MarcelKleiner/ViseClampingDevice/Hardware/Cobot/Cobot/Fertigungsdaten/Cobot-Edge_Cuts.pdf

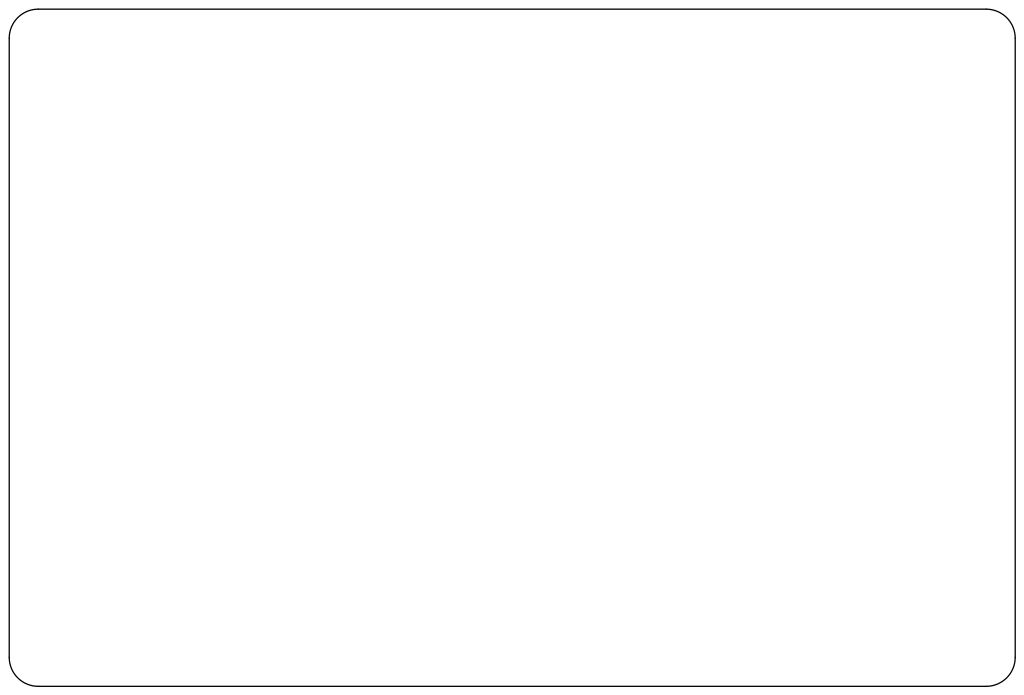
[picture p5: page 1]
