MarcelKleiner/ViseClampingDevice/Hardware/Cobot/Cobot/Fertigungsdaten/Cobot-F_Fab.pdf

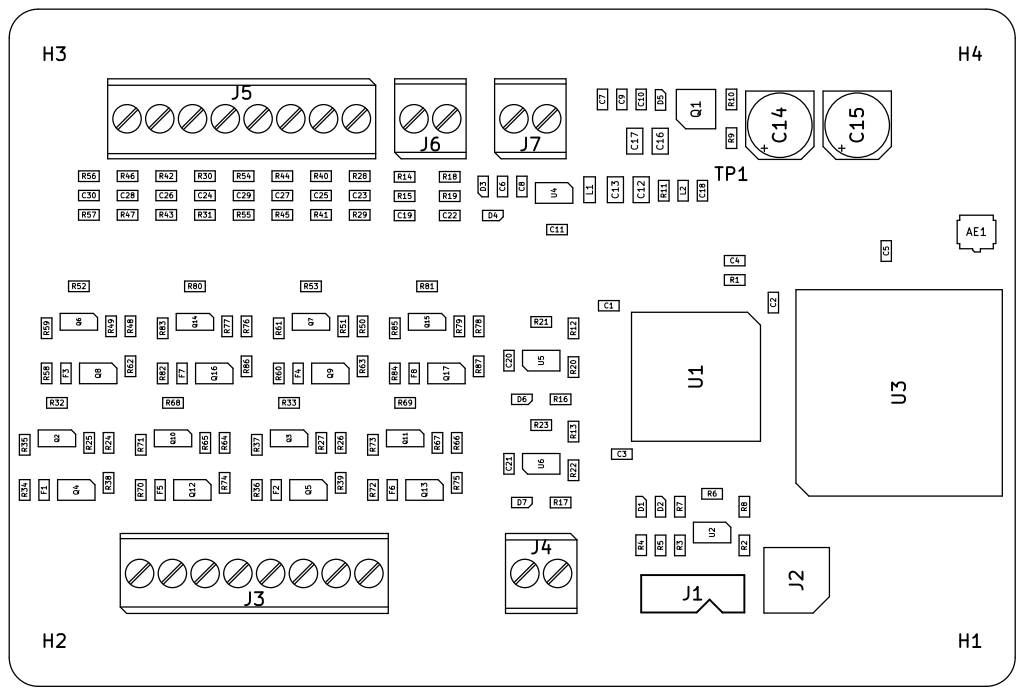
[picture p6: page 1]
