MarcelKleiner/ViseClampingDevice/Hardware/Spanner/Spanner/Fertigungsdaten/Spanner-F_Fab.pdf

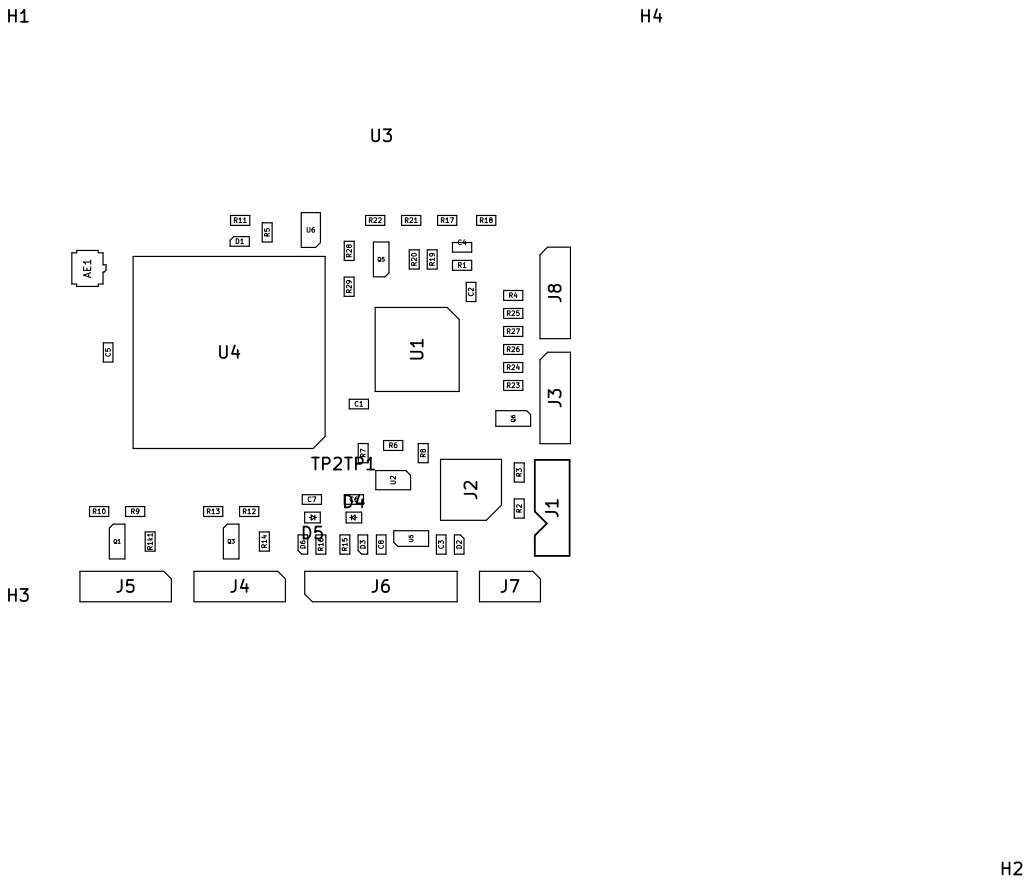
[picture p7: page 1]
