MarcelKleiner/ViseClampingDevice/Hardware/PowerSwitch/PowerSwitch/PowerSwitch.kicad_pcb

## KiCad design Hardware/PowerSwitch/PowerSwitch/PowerSwitch.kicad_pcb (2023-12-19)

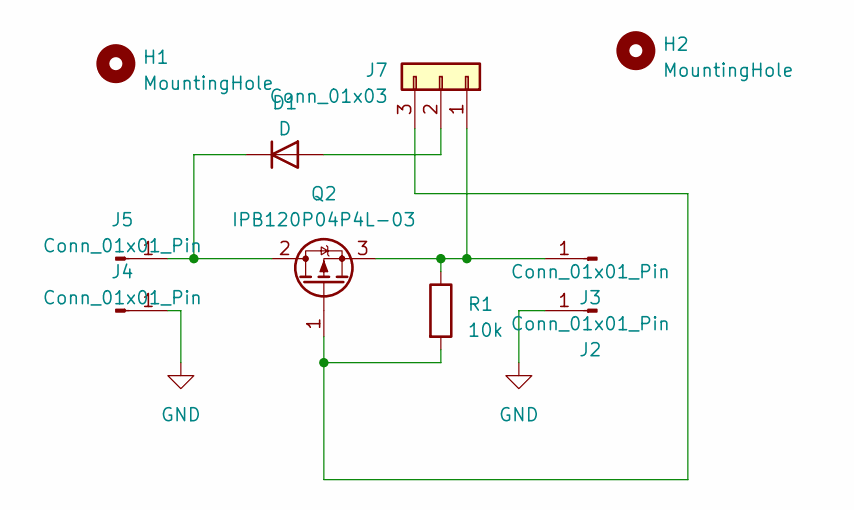
[picture p8: schematic PowerSwitch.kicad_sch]

Parts:
D1: D; D_1206_3216Metric
H1, H2: MountingHole; MountingHole_3.2mm_M3
J2, J3, J4, J5: Conn_01x01_Pin; MountingHole_3.2mm_M3_Pad_Via
J7: Conn_01x03; TerminalBlock_Phoenix_MPT-0,5-3-2.54_1x03_P2.54mm_Horizontal
Q2: IPB120P04P4L-03; TO-220-3_Vertical
R1: 10k; R_1206_3216Metric

Connections:
GND: J2.1, J4.1
unnamed: D1.2 (A), J7.2
unnamed: D1.1 (K), J5.1, Q2.2 (D)
unnamed: J3.1, J7.1, Q2.3 (S), R1.1
unnamed: J7.3, Q2.1 (G), R1.2

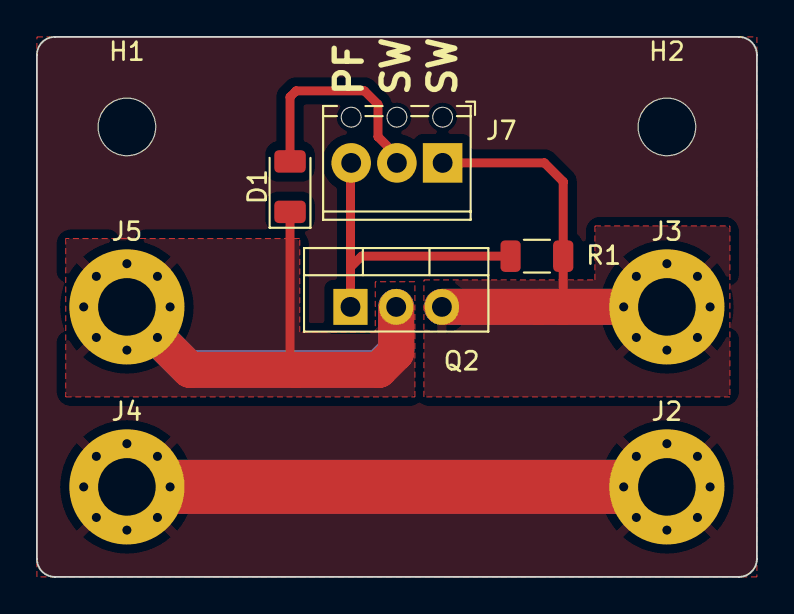
[picture p9: board PowerSwitch.kicad_pcb from above]

Board: 2 copper layers, 40.0 x 30.0 mm, 10 parts (0 on the bottom side), 5 nets.
