MarcelKleiner/ViseClampingDevice/Hardware/Cobot/Cobot/Cobot.kicad_pcb

## KiCad design Hardware/Cobot/Cobot/Cobot.kicad_pcb (2023-07-03)

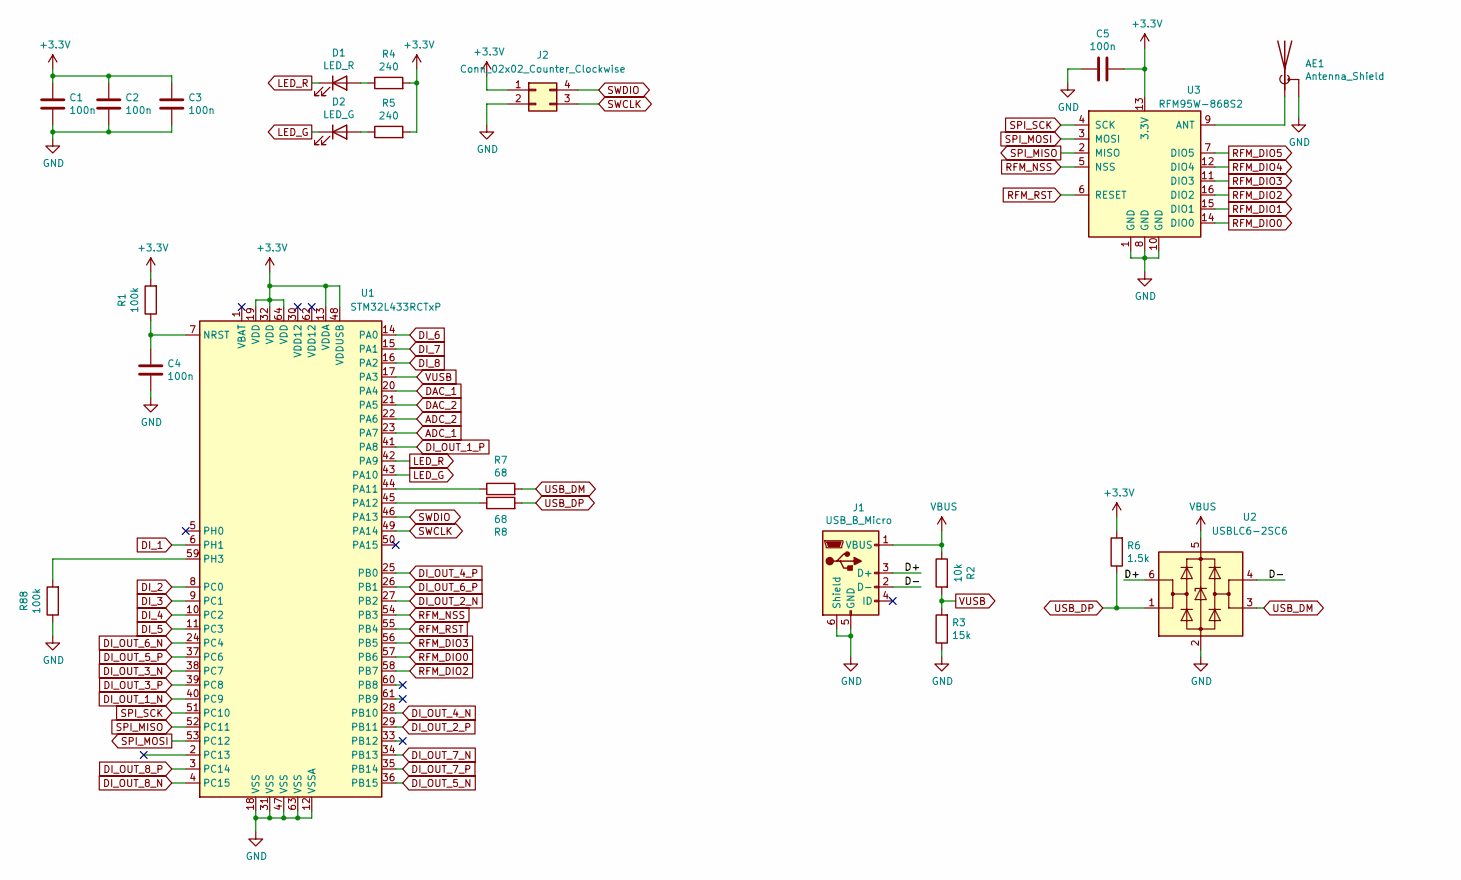
[picture p10: schematic Main.kicad_sch, part in row 1, column 1]

Parts:
AE1: Antenna_Shield; U.FL_Hirose_U.FL-R-SMT-1_Vertical; Mouser Nr. 712-CONUFL001-SMD-T
C1, C2, C3, C4, C5: 100n; C_0603_1608Metric; Mouser Nr. 187-CL10B104KB8NNWC
D1: LED_R; LED_0603_1608Metric; Mouser Nr. 696-SMLLXFP0603SICTR
D2: LED_G; LED_0603_1608Metric; Mouser Nr. 696-SMLLXFP0603SUGCT
J1: USB_B_Micro; USB_Micro-B_Wuerth_614105150721_Vertical; Mouser Nr. 710-614105150721
J2: Conn_02x02_Counter_Clockwise; PinHeader_2x02_P2.54mm_Vertical
R1, R88: 100k; R_0603_1608Metric; Mouser Nr. 71-CRCW0603100KFKEAC
R2: 10k; R_0603_1608Metric; Mouser Nr. 603-RT0603FRE0710KL
R3: 15k; R_0603_1608Metric; Mouser Nr. 667-ERJ-3EKF1502V
R4, R5: 240; R_0603_1608Metric; Mouser Nr. 603-RC0603FR-13240RL
R6: 1.5k; R_0603_1608Metric; Mouser Nr. 603-RT0603FRE101K5L
R7, R8: 68; R_0603_1608Metric; Mouser Nr. 603-RC0603JR-0768RL
U1: STM32L433RCTxP; LQFP-64_10x10mm_P0.5mm; Mouser Nr. 511-STM32L433RCT6P
U2: USBLC6-2SC6; SOT-23-6; Mouser Nr. 511-USBLC6-2SC6
U3: RFM95W-868S2; HOPERF_RFM9XW_SMD; Mouser Nr. 223-RFM95W-868S2

Connections:
+3.3V: C1.1, C2.1, C3.1, C5.2, J2.1, R1.2, R4.2, R5.2, R6.2, U1.13 (VDDA), U1.19 (VDD), U1.32 (VDD), U1.48 (VDDUSB), U1.64 (VDD), U3.13 (3.3V); also elsewhere on the board
/Main/D+: J1.3 (D+), U2.6 (I/O1)
/Main/D-: J1.2 (D-), U2.4 (I/O2)
ADC_1: U1.23 (PA7); also elsewhere on the board
ADC_2: U1.22 (PA6); also elsewhere on the board
DAC_1: U1.20 (PA4); also elsewhere on the board
DAC_2: U1.21 (PA5); also elsewhere on the board
DI_1: U1.6 (PH1); also elsewhere on the board
DI_2: U1.8 (PC0); also elsewhere on the board
DI_3: U1.9 (PC1); also elsewhere on the board
DI_4: U1.10 (PC2); also elsewhere on the board
DI_5: U1.11 (PC3); also elsewhere on the board
DI_6: U1.14 (PA0); also elsewhere on the board
DI_7: U1.15 (PA1); also elsewhere on the board
DI_8: U1.16 (PA2); also elsewhere on the board
DI_OUT_1_N: U1.40 (PC9); also elsewhere on the board
DI_OUT_1_P: U1.41 (PA8); also elsewhere on the board
DI_OUT_2_N: U1.27 (PB2); also elsewhere on the board
DI_OUT_2_P: U1.29 (PB11); also elsewhere on the board
DI_OUT_3_N: U1.38 (PC7); also elsewhere on the board
DI_OUT_3_P: U1.39 (PC8); also elsewhere on the board
DI_OUT_4_N: U1.28 (PB10); also elsewhere on the board
DI_OUT_4_P: U1.25 (PB0); also elsewhere on the board
DI_OUT_5_N: U1.36 (PB15); also elsewhere on the board
DI_OUT_5_P: U1.37 (PC6); also elsewhere on the board
DI_OUT_6_N: U1.24 (PC4); also elsewhere on the board
DI_OUT_6_P: U1.26 (PB1); also elsewhere on the board
DI_OUT_7_N: U1.34 (PB13); also elsewhere on the board
DI_OUT_7_P: U1.35 (PB14); also elsewhere on the board
DI_OUT_8_N: U1.4 (PC15); also elsewhere on the board
DI_OUT_8_P: U1.3 (PC14); also elsewhere on the board
LED_G: D2.1 (K), U1.43 (PA10)
LED_R: D1.1 (K), U1.42 (PA9)
unnamed: AE1.1 (A), U3.9 (ANT)
unnamed: D1.2 (A), R4.1
unnamed: D2.2 (A), R5.1
unnamed: C4.1, R1.1, U1.7 (NRST)
unnamed: R7.1, U1.44 (PA11)
unnamed: R8.1, U1.45 (PA12)
unnamed: R88.2, U1.59 (PH3)
RFM_DIO0: U1.57 (PB6), U3.14 (DIO0)
RFM_DIO1: U3.15 (DIO1)
RFM_DIO2: U1.58 (PB7), U3.16 (DIO2)
RFM_DIO3: U1.56 (PB5), U3.11 (DIO3)
RFM_DIO4: U3.12 (DIO4)
RFM_DIO5: U3.7 (DIO5)
RFM_NSS: U1.54 (PB3), U3.5 (NSS)
RFM_RST: U1.55 (PB4), U3.6 (RESET)
SPI_MISO: U1.52 (PC11), U3.2 (MISO)
SPI_MOSI: U1.53 (PC12), U3.3 (MOSI)
SPI_SCK: U1.51 (PC10), U3.4 (SCK)
SWCLK: J2.3, U1.49 (PA14)
SWDIO: J2.4, U1.46 (PA13)
USB_DM: R7.2, U2.3 (I/O2)
USB_DP: R6.1, R8.2, U2.1 (I/O1)
VBUS: J1.1 (VBUS), R2.1, U2.5 (VBUS); also elsewhere on the board
VUSB: R2.2, R3.2, U1.17 (PA3)

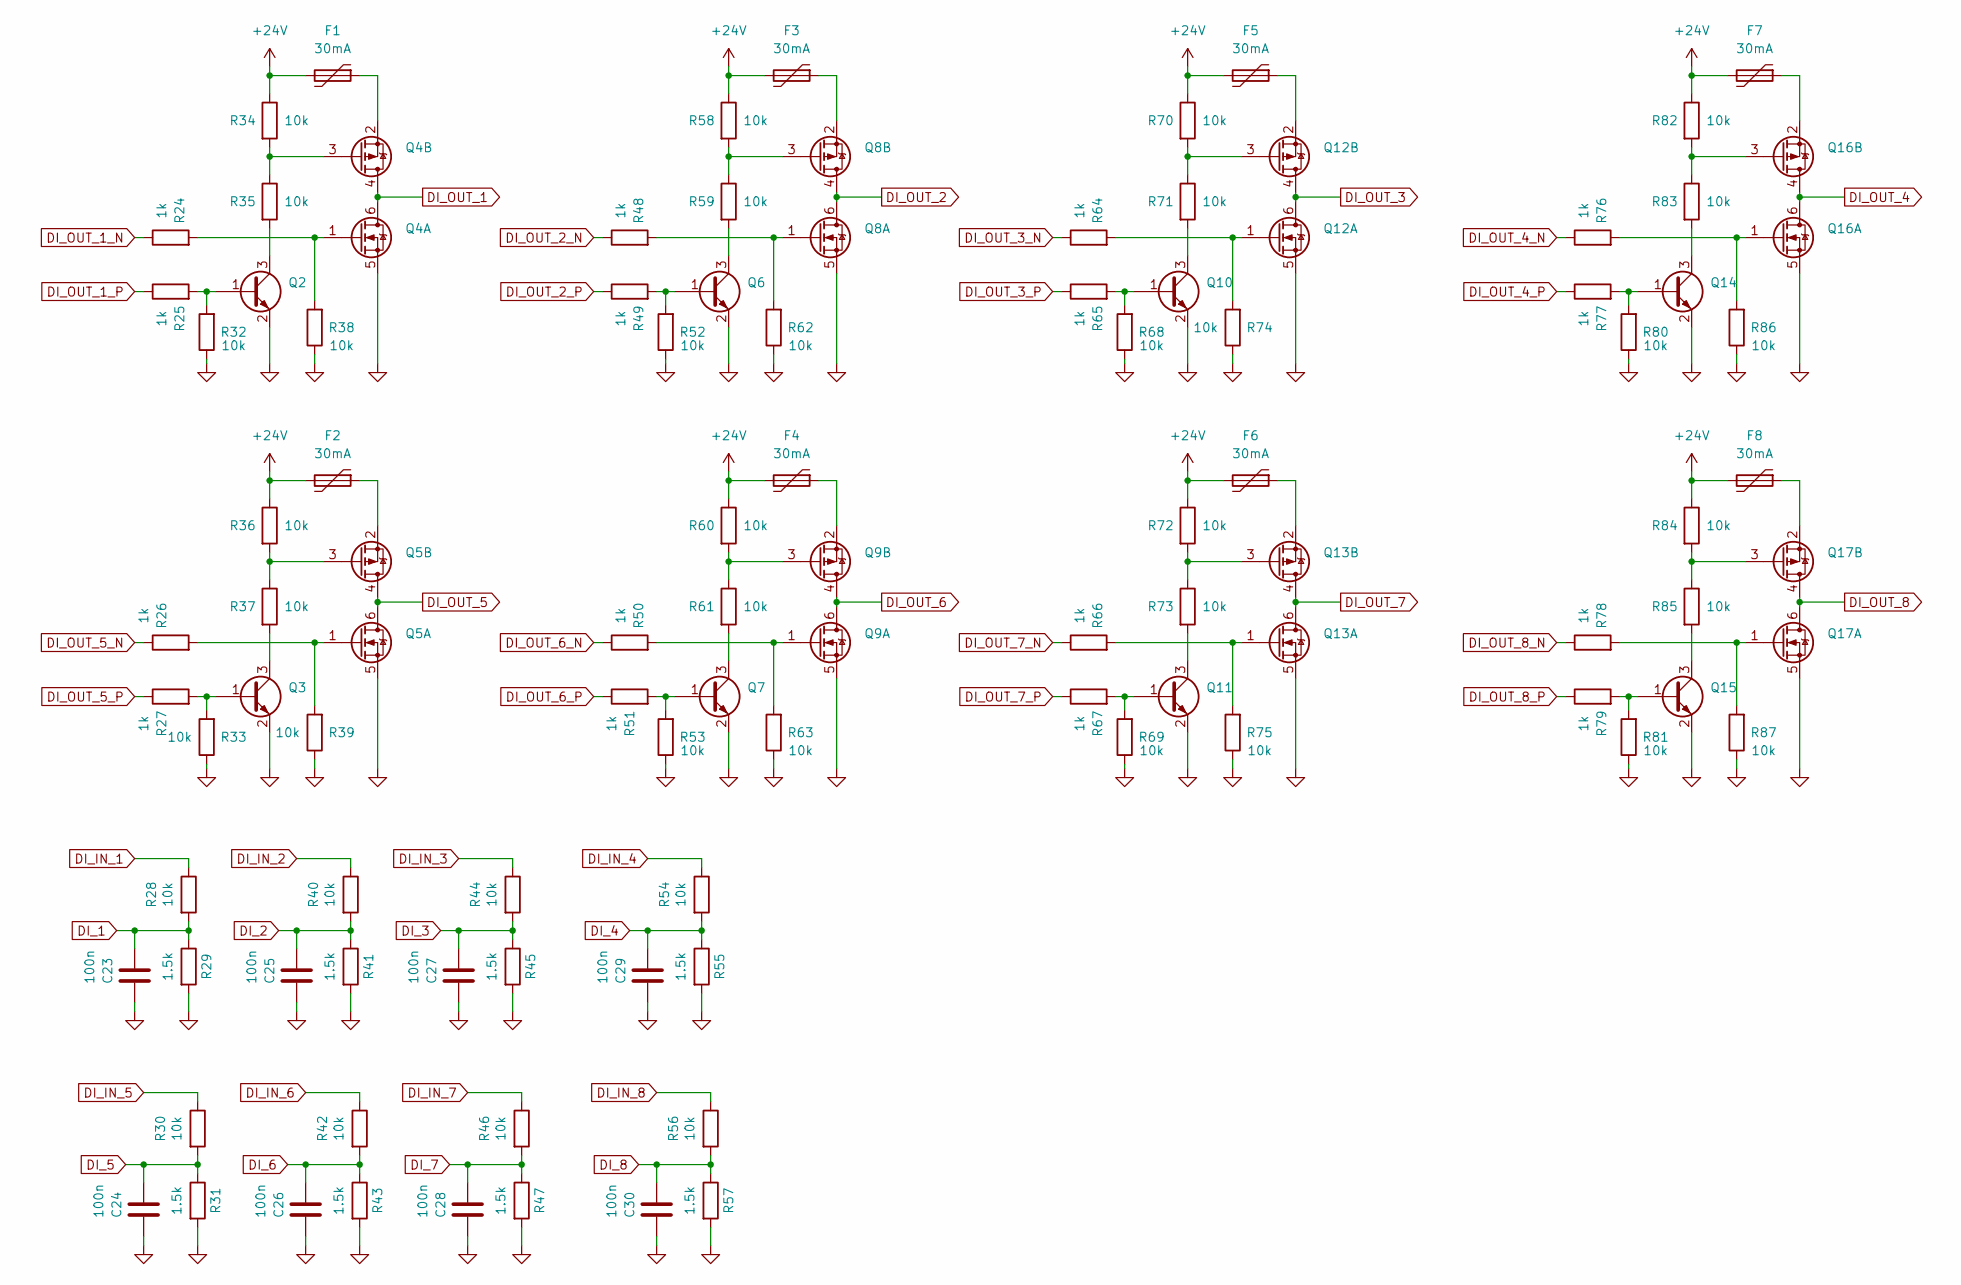
[picture p11: schematic IO_Digital.kicad_sch]

Parts:
C23, C24, C25, C26, C27, C28, C29, C30: 100n; C_0603_1608Metric; Mouser Nr. 187-CL10B104KB8NNWC
F1, F2, F3, F4, F5, F6, F7, F8: 30mA; Fuse_0603_1608Metric; Mouser Nr. 530-0ZCM0003FF2G
Q2, Q3, Q6, Q7, Q10, Q11, Q14, Q15: SOT-23; Mouser Nr. 771-BC846A235
Q4, Q5, Q8, Q9, Q12, Q13, Q16, Q17: SOT-23-6; Mouser Nr. 621-DMC2700UDM-7
R24, R25, R26, R27, R48, R49, R50, R51, R64, R65, R66, R67, R76, R77, R78, R79: 1k; R_0603_1608Metric; Mouser Nr. 603-RT0603FRE071KL
R28, R30, R32, R33, R34, R35, R36, R37, R38, R39, R40, R42, R44, R46, R52, R53, R54, R56, R58, R59, R60, R61, R62, R63, R68, R69, R70, R71, R72, R73, R74, R75, R80, R81, R82, R83, R84, R85, R86, R87: 10k; R_0603_1608Metric; Mouser Nr. 603-RT0603FRE0710KL
R29, R31, R41, R43, R45, R47, R55, R57: 1.5k; R_0603_1608Metric; Mouser Nr. 603-RT0603FRE101K5L

Connections:
+24V: F1.2, F2.2, F3.2, F4.2, F5.2, F6.2, F7.2, F8.2, R34.1, R36.1, R58.1, R60.1, R70.1, R72.1, R82.1, R84.1; also elsewhere on the board
DI_1: C23.1, R28.2, R29.1; also elsewhere on the board
DI_2: C25.1, R40.2, R41.1; also elsewhere on the board
DI_3: C27.1, R44.2, R45.1; also elsewhere on the board
DI_4: C29.1, R54.2, R55.1; also elsewhere on the board
DI_5: C24.1, R30.2, R31.1; also elsewhere on the board
DI_6: C26.1, R42.2, R43.1; also elsewhere on the board
DI_7: C28.1, R46.2, R47.1; also elsewhere on the board
DI_8: C30.1, R56.2, R57.1; also elsewhere on the board
DI_IN_1: R28.1; also elsewhere on the board
DI_IN_2: R40.1; also elsewhere on the board
DI_IN_3: R44.1; also elsewhere on the board
DI_IN_4: R54.1; also elsewhere on the board
DI_IN_5: R30.1; also elsewhere on the board
DI_IN_6: R42.1; also elsewhere on the board
DI_IN_7: R46.1; also elsewhere on the board
DI_IN_8: R56.1; also elsewhere on the board
DI_OUT_1: Q4.4 (D), Q4.6 (D); also elsewhere on the board
DI_OUT_1_N: R24.1; also elsewhere on the board
DI_OUT_1_P: R25.1; also elsewhere on the board
DI_OUT_2: Q8.4 (D), Q8.6 (D); also elsewhere on the board
DI_OUT_2_N: R48.1; also elsewhere on the board
DI_OUT_2_P: R49.1; also elsewhere on the board
DI_OUT_3: Q12.4 (D), Q12.6 (D); also elsewhere on the board
DI_OUT_3_N: R64.1; also elsewhere on the board
DI_OUT_3_P: R65.1; also elsewhere on the board
DI_OUT_4: Q16.4 (D), Q16.6 (D); also elsewhere on the board
DI_OUT_4_N: R76.1; also elsewhere on the board
DI_OUT_4_P: R77.1; also elsewhere on the board
DI_OUT_5: Q5.4 (D), Q5.6 (D); also elsewhere on the board
DI_OUT_5_N: R26.1; also elsewhere on the board
DI_OUT_5_P: R27.1; also elsewhere on the board
DI_OUT_6: Q9.4 (D), Q9.6 (D); also elsewhere on the board
DI_OUT_6_N: R50.1; also elsewhere on the board
DI_OUT_6_P: R51.1; also elsewhere on the board
DI_OUT_7: Q13.4 (D), Q13.6 (D); also elsewhere on the board
DI_OUT_7_N: R66.1; also elsewhere on the board
DI_OUT_7_P: R67.1; also elsewhere on the board
DI_OUT_8: Q17.4 (D), Q17.6 (D); also elsewhere on the board
DI_OUT_8_N: R78.1; also elsewhere on the board
DI_OUT_8_P: R79.1; also elsewhere on the board
unnamed: Q2.1 (B), R25.2, R32.2
unnamed: Q2.3 (C), R35.2
unnamed: Q3.1 (B), R27.2, R33.2
unnamed: Q3.3 (C), R37.2
unnamed: Q4.1 (G), R24.2, R38.2
unnamed: Q4.3 (G), R34.2, R35.1
unnamed: F1.1, Q4.2 (S)
unnamed: Q5.1 (G), R26.2, R39.2
unnamed: Q5.3 (G), R36.2, R37.1
unnamed: F2.1, Q5.2 (S)
unnamed: Q6.1 (B), R49.2, R52.2
unnamed: Q6.3 (C), R59.2
unnamed: Q7.1 (B), R51.2, R53.2
unnamed: Q7.3 (C), R61.2
unnamed: Q8.1 (G), R48.2, R62.2
unnamed: Q8.3 (G), R58.2, R59.1
unnamed: F3.1, Q8.2 (S)
unnamed: Q9.1 (G), R50.2, R63.2
unnamed: Q9.3 (G), R60.2, R61.1
unnamed: F4.1, Q9.2 (S)
unnamed: Q10.1 (B), R65.2, R68.2
unnamed: Q10.3 (C), R71.2
unnamed: Q11.1 (B), R67.2, R69.2
unnamed: Q11.3 (C), R73.2
unnamed: Q12.1 (G), R64.2, R74.2
unnamed: Q12.3 (G), R70.2, R71.1
unnamed: F5.1, Q12.2 (S)
unnamed: Q13.1 (G), R66.2, R75.2
unnamed: Q13.3 (G), R72.2, R73.1
unnamed: F6.1, Q13.2 (S)
unnamed: Q14.1 (B), R77.2, R80.2
unnamed: Q14.3 (C), R83.2
unnamed: Q15.1 (B), R79.2, R81.2
unnamed: Q15.3 (C), R85.2
unnamed: Q16.1 (G), R76.2, R86.2
unnamed: Q16.3 (G), R82.2, R83.1
unnamed: F7.1, Q16.2 (S)
unnamed: Q17.1 (G), R78.2, R87.2
unnamed: Q17.3 (G), R84.2, R85.1
unnamed: F8.1, Q17.2 (S)

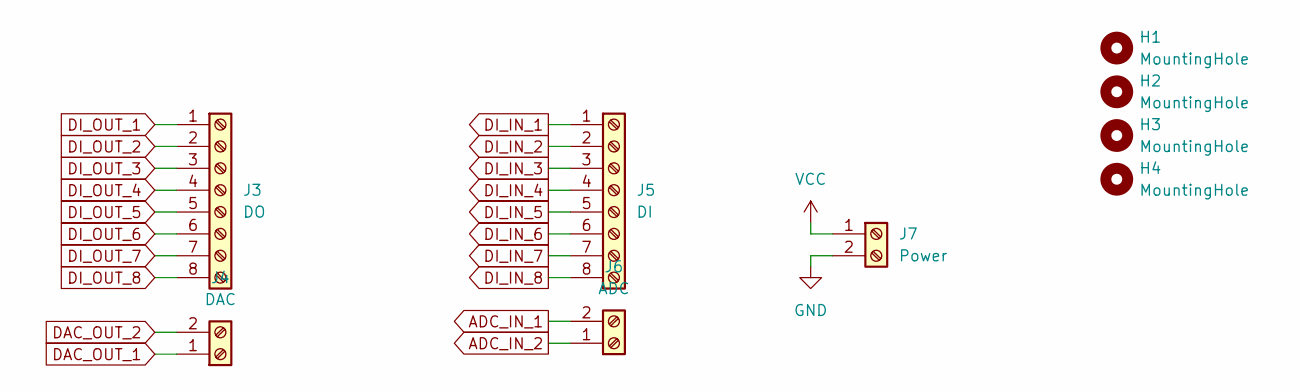
[picture p12: schematic Connection.kicad_sch]

Parts:
H1, H2, H3, H4: MountingHole; MountingHole_3.2mm_M3
J3: DO; TerminalBlock_Phoenix_MPT-0,5-8-2.54_1x08_P2.54mm_Horizontal
J4: DAC; TerminalBlock_Phoenix_MPT-0,5-2-2.54_1x02_P2.54mm_Horizontal
J5: DI; TerminalBlock_Phoenix_MPT-0,5-8-2.54_1x08_P2.54mm_Horizontal
J6: ADC; TerminalBlock_Phoenix_MPT-0,5-2-2.54_1x02_P2.54mm_Horizontal
J7: Power; TerminalBlock_Phoenix_MPT-0,5-2-2.54_1x02_P2.54mm_Horizontal

Connections:
ADC_IN_1: J6.2; also elsewhere on the board
ADC_IN_2: J6.1; also elsewhere on the board
DAC_OUT_1: J4.1; also elsewhere on the board
DAC_OUT_2: J4.2; also elsewhere on the board
DI_IN_1: J5.1; also elsewhere on the board
DI_IN_2: J5.2; also elsewhere on the board
DI_IN_3: J5.3; also elsewhere on the board
DI_IN_4: J5.4; also elsewhere on the board
DI_IN_5: J5.5; also elsewhere on the board
DI_IN_6: J5.6; also elsewhere on the board
DI_IN_7: J5.7; also elsewhere on the board
DI_IN_8: J5.8; also elsewhere on the board
DI_OUT_1: J3.1; also elsewhere on the board
DI_OUT_2: J3.2; also elsewhere on the board
DI_OUT_3: J3.3; also elsewhere on the board
DI_OUT_4: J3.4; also elsewhere on the board
DI_OUT_5: J3.5; also elsewhere on the board
DI_OUT_6: J3.6; also elsewhere on the board
DI_OUT_7: J3.7; also elsewhere on the board
DI_OUT_8: J3.8; also elsewhere on the board
VCC: J7.1; also elsewhere on the board

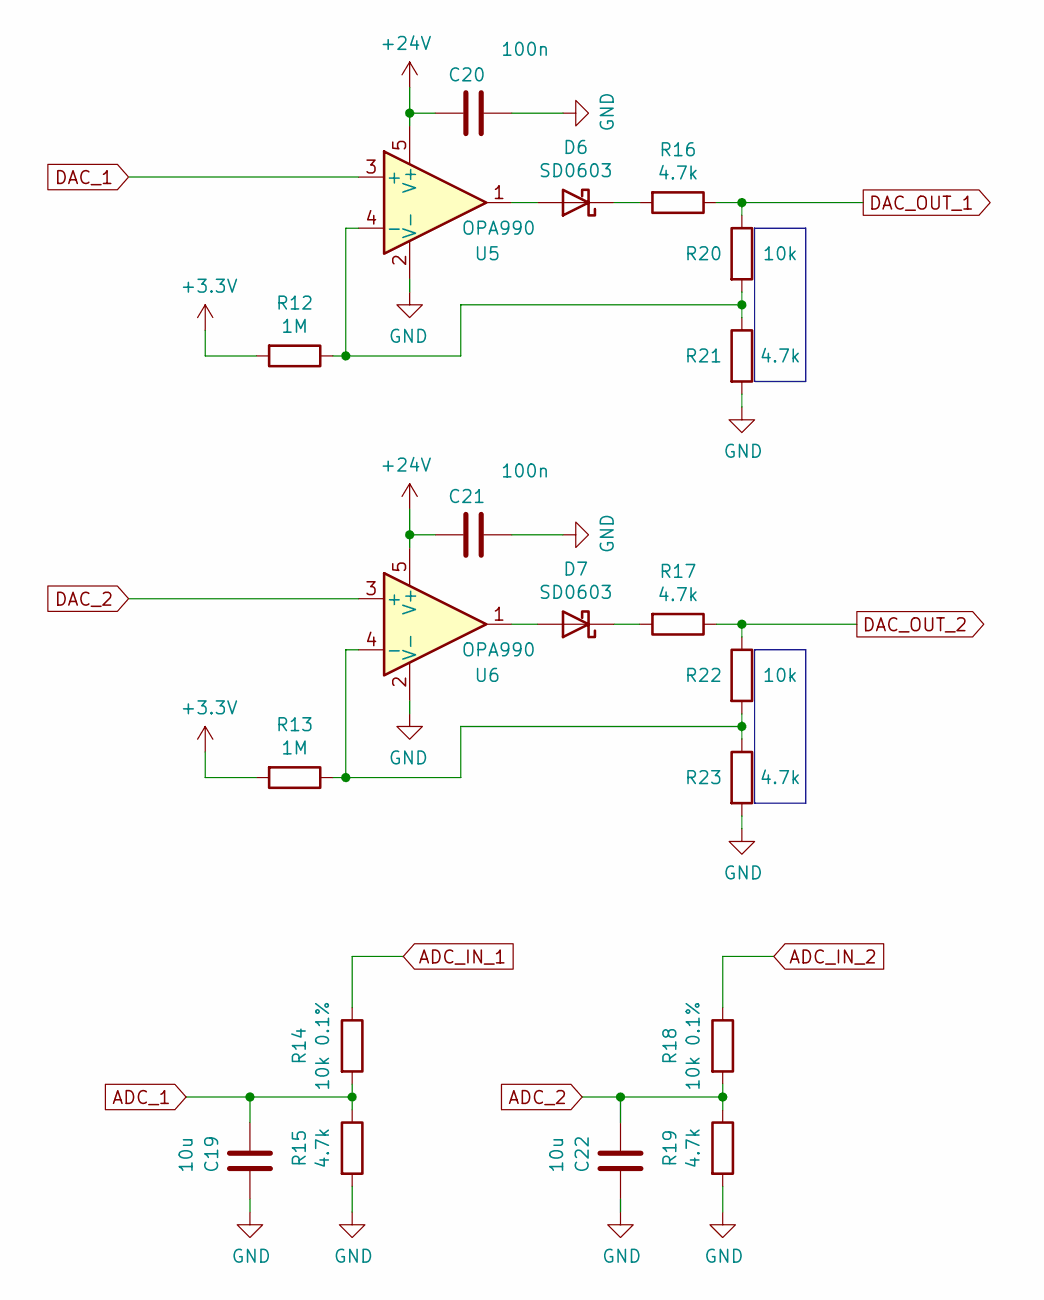
[picture p13: schematic IO_Analog.kicad_sch]

Parts:
C19, C22: 10u; C_0603_1608Metric; Mouser Nr. 187-CL10A106MA8NRNC
C20, C21: 100n; C_0603_1608Metric; Mouser Nr. 187-CL10B104KB8NNWC
D6, D7: SD0603; D_0603_1608Metric; Mouser Nr. 581-SD0603S040S0R2
R12, R13: 1M; R_0603_1608Metric; Mouser Nr. 667-ERJ-3GEYJ105V
R14, R18: 10k 0.1%; R_0603_1608Metric; Mouser Nr. 284-APC0603B10K0N
R15, R16, R17, R19, R21, R23: 4.7k; R_0603_1608Metric; Mouser Nr. 603-RT0603FRE074K7L
R20, R22: 10k; R_0603_1608Metric; Mouser Nr. 603-RT0603FRE0710KL
U5, U6: OPA990; SOT-23-5; Mouser Nr. 595-OPA990IDBVR

Connections:
+3.3V: R12.2, R13.2; also elsewhere on the board
+24V: C20.1, C21.1, U5.5 (V+), U6.5 (V+); also elsewhere on the board
ADC_1: C19.1, R14.2, R15.1; also elsewhere on the board
ADC_2: C22.1, R18.2, R19.1; also elsewhere on the board
ADC_IN_1: R14.1; also elsewhere on the board
ADC_IN_2: R18.1; also elsewhere on the board
DAC_1: U5.3 (+); also elsewhere on the board
DAC_2: U6.3 (+); also elsewhere on the board
DAC_OUT_1: R16.1, R20.1; also elsewhere on the board
DAC_OUT_2: R17.1, R22.1; also elsewhere on the board
unnamed: D6.2 (A), U5.1
unnamed: D6.1 (K), R16.2
unnamed: D7.2 (A), U6.1
unnamed: D7.1 (K), R17.2
unnamed: R12.1, R20.2, R21.1, U5.4 (-)
unnamed: R13.1, R22.2, R23.1, U6.4 (-)

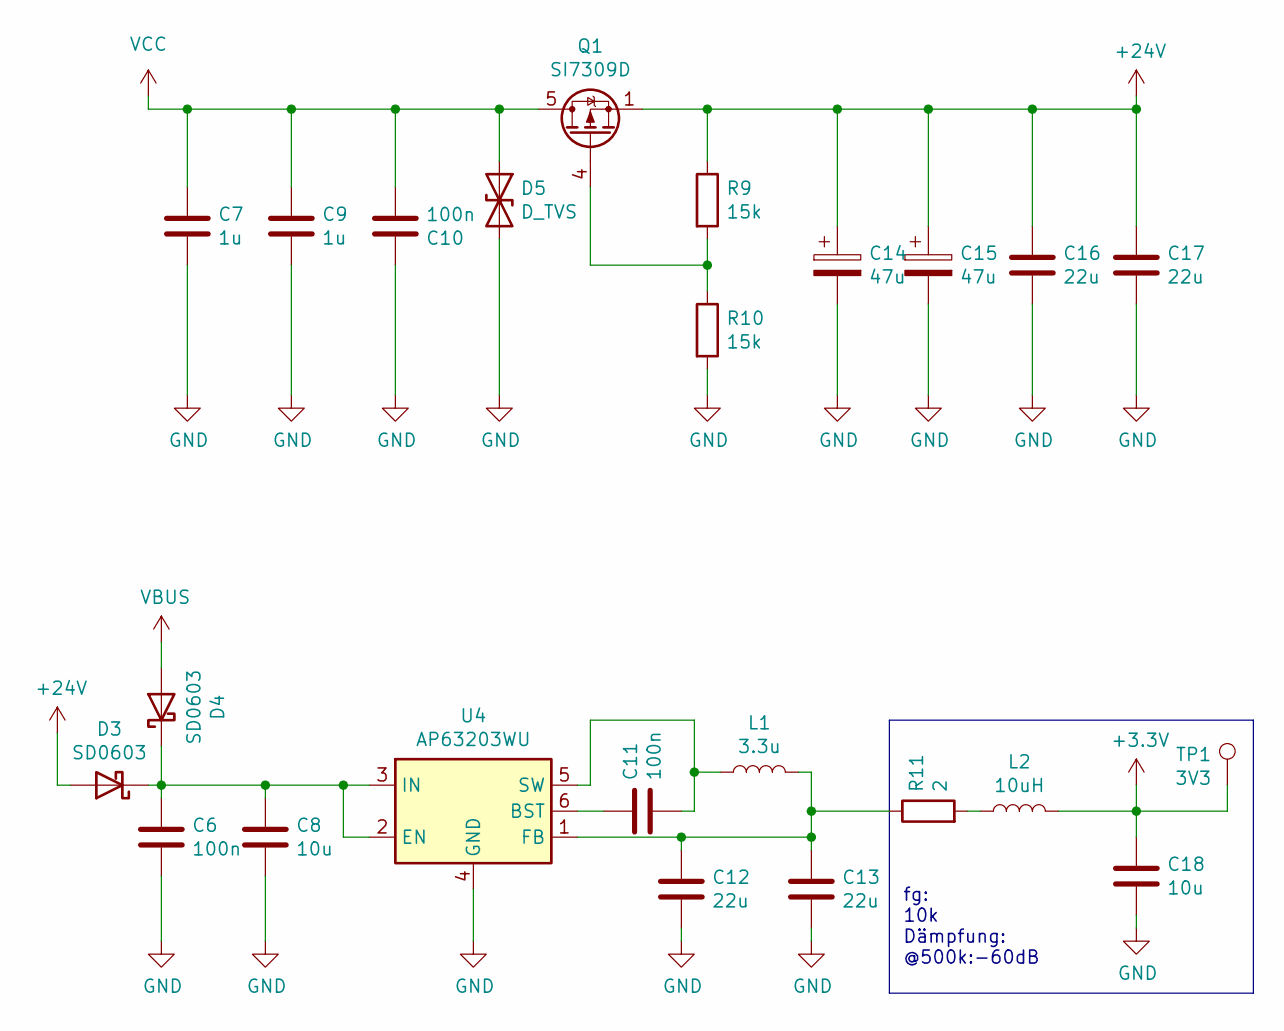
[picture p14: schematic Supply.kicad_sch]

Parts:
C6, C10, C11: 100n; C_0603_1608Metric; Mouser Nr. 187-CL10B104KB8NNWC
C7, C9: 1u; C_0603_1608Metric; Mouser Nr. 187-CL10A105KA8NFNC
C8, C18: 10u; C_0603_1608Metric; Mouser Nr. 187-CL10A106MA8NRNC
C12, C13, C16, C17: 22u; C_0805_2012Metric; Mouser Nr. 187-CL21A226MAYNNNE
C14, C15: 47u; CP_Elec_5x5.8; Mouser Nr. 667-EEE-FT1V470AR
D3, D4: SD0603; D_0603_1608Metric; Mouser Nr. 581-SD0603S040S0R2
D5: D_TVS; D_0603_1608Metric
L1: 3.3u; L_0805_2012Metric; Mouser Nr. 70-IMC0805ER3R3J01
L2: 10uH; L_0603_1608Metric; Mouser Nr. 81-LQM18DH100M70L
Q1: SI7309D; Vishay_PowerPAK_1212-8_Single; Mouser Nr. 781-SI7309DN-T1-E3
R9, R10: 15k; R_0603_1608Metric; Mouser Nr. 667-ERJ-3EKF1502V
R11: 2; R_0603_1608Metric; Mouser Nr. 652-CR0603-J/-2R0ELF
TP1: 3V3; TestPoint_Pad_D1.0mm
U4: AP63203WU; SOT-23-6; Mouser Nr. 621-AP63203WU-7

Connections:
+3.3V: C18.2, L2.2, TP1.1; also elsewhere on the board
+24V: C14.1, C15.1, C16.2, C17.2, D3.2 (A), Q1.1 (S), Q1.2 (S), Q1.3 (S), R9.1; also elsewhere on the board
unnamed: C6.1, C8.1, D3.1 (K), D4.1 (K), U4.2 (EN), U4.3 (IN)
unnamed: L2.1, R11.2
unnamed: Q1.4 (G), R9.2, R10.1
unnamed: C11.2, U4.6 (BST)
unnamed: C12.2, C13.2, L1.2, R11.1, U4.1 (FB)
unnamed: C11.1, L1.1, U4.5 (SW)
VBUS: D4.2 (A); also elsewhere on the board
VCC: C7.2, C9.2, C10.1, D5.1 (A1), Q1.5 (D); also elsewhere on the board

Notes on the sheet:
fg: 10k Dämpfung: @500k:-60dB

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
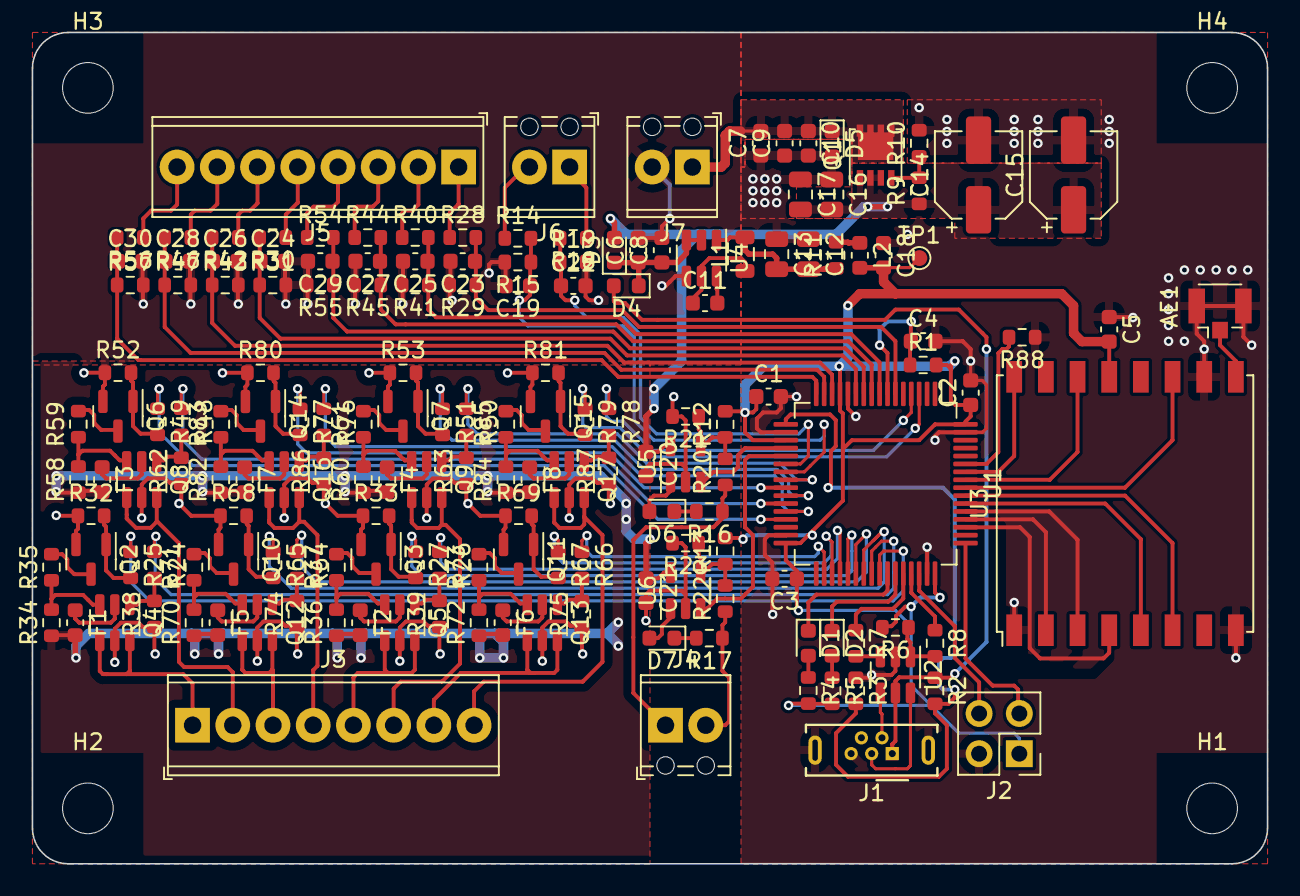
[picture p15: board Cobot.kicad_pcb from above]

Board: 2 copper layers, 78.0 x 52.5 mm, 171 parts (0 on the bottom side), 129 nets.
