MarcelKleiner/ViseClampingDevice/Hardware/Spanner/Spanner/Spanner.kicad_pcb

## KiCad design Hardware/Spanner/Spanner/Spanner.kicad_pcb (2023-01-22)

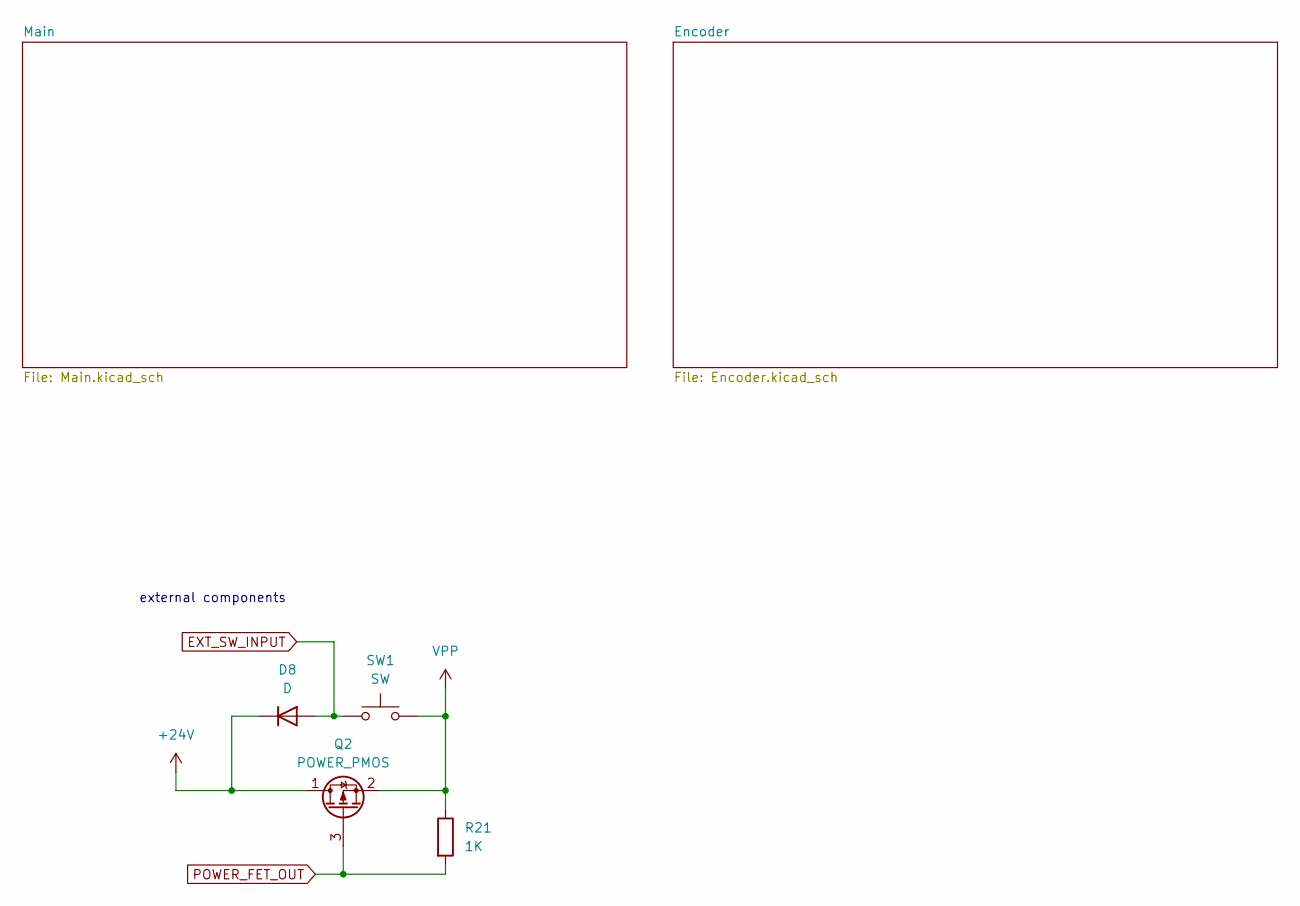
[picture p16: schematic Spanner.kicad_sch]

Parts:
D8: D
Q2: POWER_PMOS
R21: 1K
SW1: SW

Connections:
unnamed: D8.1 (K), Q2.1 (D)
unnamed: D8.2 (A), SW1.1 (A), SW1.2 (A)
unnamed: Q2.2 (S), R21.1, SW1.3 (B), SW1.4 (B)
unnamed: Q2.3 (G), R21.2

Notes on the sheet:
external components

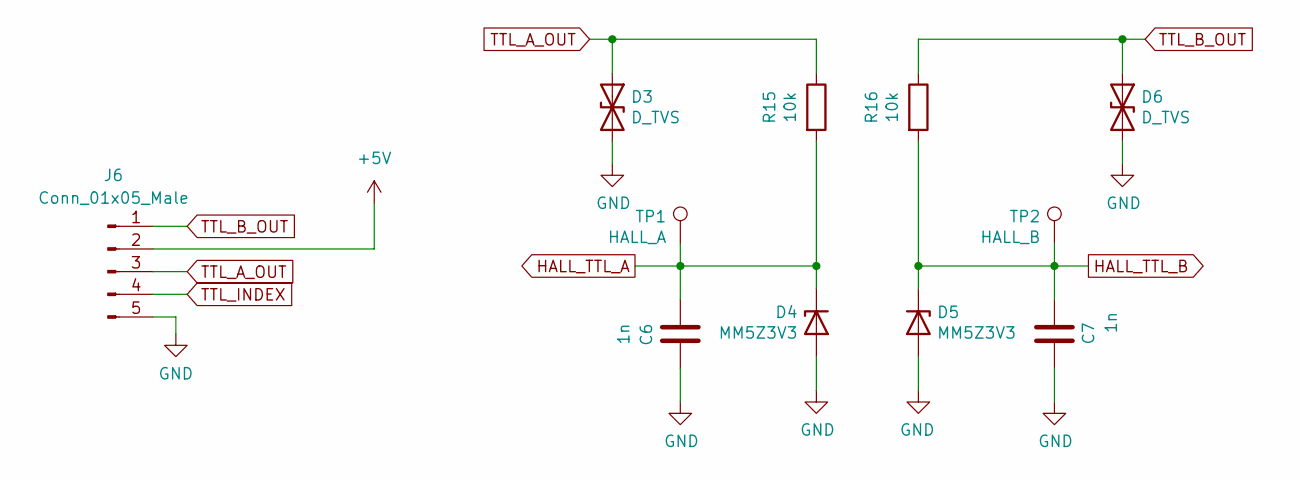
[picture p17: schematic Encoder.kicad_sch]

Parts:
C6, C7: 1n; C_0603_1608Metric; Mouser Nr. 581-06035C102K
D3, D6: D_TVS; D_0603_1608Metric; Mouser Nr. 652-CGA0603MLC-24E
D4, D5: MM5Z3V3; D_SOD-523; Mouser Nr. 863-MM5Z3V3T1G
J6: Conn_01x05_Male; PinHeader_1x05_P2.54mm_Vertical
R15, R16: 10k; R_0603_1608Metric; Mouser Nr. 603-RT0603FRE0710KL
TP1: HALL_A; TestPoint_Pad_D1.0mm
TP2: HALL_B; TestPoint_Pad_D1.0mm

Connections:
+5V: J6.2; also elsewhere on the board
GND: C6.1, C7.2, D3.2 (A2), D4.2 (A), D5.2 (A), D6.2 (A2), J6.5; also elsewhere on the board
HALL_TTL_A: C6.2, D4.1 (K), R15.2, TP1.1; also elsewhere on the board
HALL_TTL_B: C7.1, D5.1 (K), R16.2, TP2.1; also elsewhere on the board
TTL_A_OUT: D3.1 (A1), J6.3, R15.1
TTL_B_OUT: D6.1 (A1), J6.1, R16.1
TTL_INDEX: J6.4
