MarcelKleiner/ViseClampingDevice/Hardware/Spanner/Spanner/Spanner.kicad_pcb

## KiCad design Hardware/Spanner/Spanner/Spanner.kicad_pcb (continued)

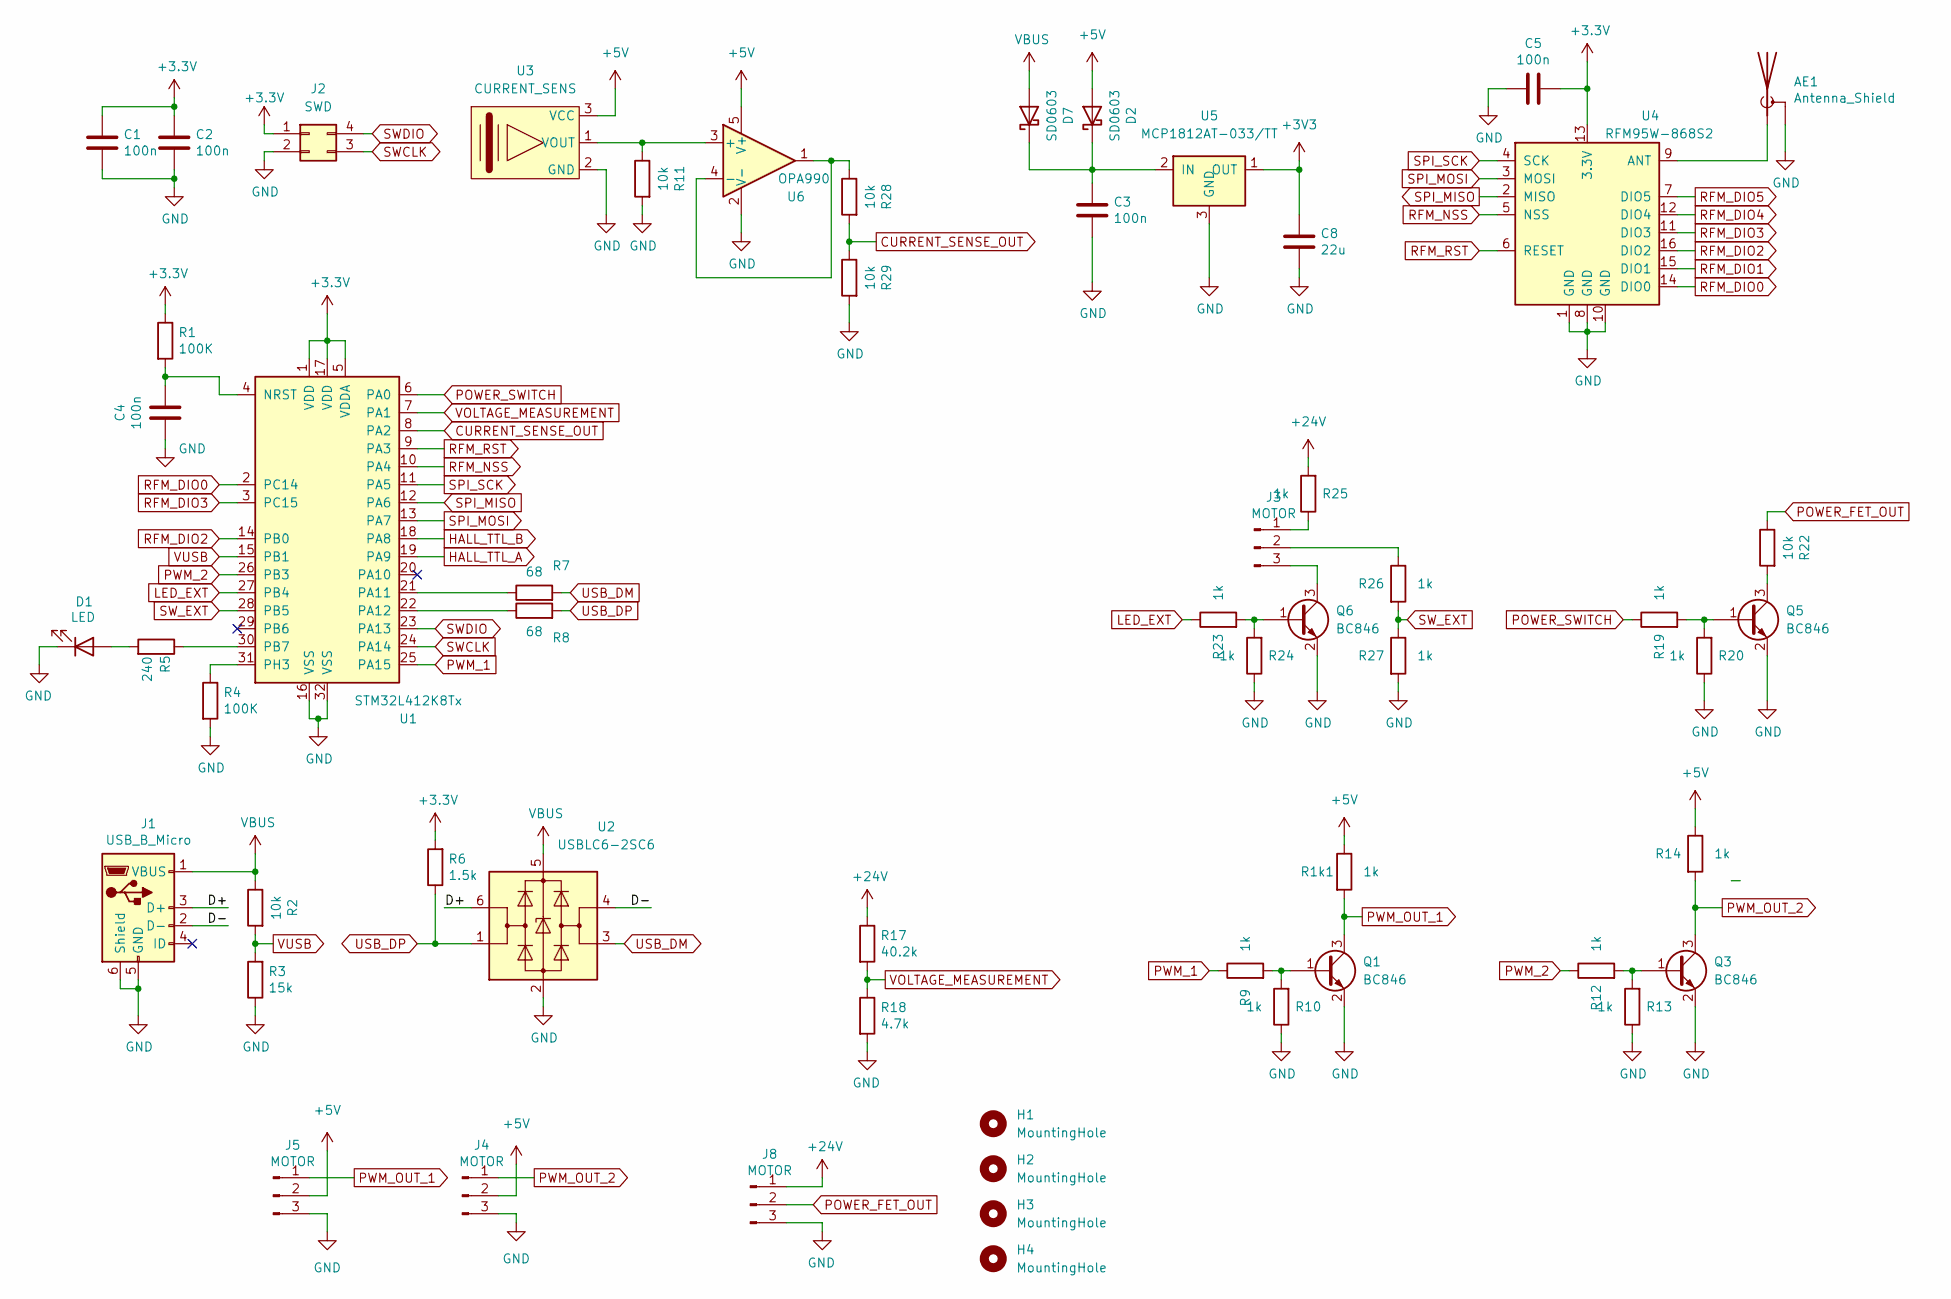
[picture p18: schematic Main.kicad_sch]

Parts:
AE1: Antenna_Shield; U.FL_Hirose_U.FL-R-SMT-1_Vertical; Mouser Nr. 712-CONUFL001-SMD-T
C1, C2, C3, C4, C5: 100n; C_0603_1608Metric; Mouser Nr. 187-CL10B104KB8NNWC
C8: 22u; C_0603_1608Metric; Mouser Nr. 187-CL21A226MAYNNNE
D1: LED; LED_0603_1608Metric; Mouser Nr. 710-150060VS75000
D2, D7: SD0603; D_0603_1608Metric; Mouser Nr. 581-SD0603S040S0R2
H1, H2, H3, H4: MountingHole; MountingHole_3.2mm_M3
J1: USB_B_Micro; USB_Micro-B_Wuerth_614105150721_Vertical; Mouser Nr. 710-614105150721
J2: SWD; PinHeader_2x02_P2.54mm_Vertical
J3, J4, J5, J8: MOTOR; PinHeader_1x03_P2.54mm_Vertical
Q1, Q3, Q5, Q6: BC846; SOT-23; Mouser Nr. 771-BC846A235
R1, R4: 100K; R_0603_1608Metric; Mouser Nr. 71-CRCW0603100KFKEAC
R1k1, R9, R10, R12, R13, R14, R19, R20, R23, R24, R25, R26, R27: 1k; R_0603_1608Metric; Mouser Nr. 603-RT0603FRE071KL
R2, R11, R22, R28, R29: 10k; R_0603_1608Metric; Mouser Nr. 603-RT0603FRE0710KL
R3: 15k; R_0603_1608Metric; Mouser Nr. 603-RT0603BRB0715KL
R5: 240; R_0603_1608Metric; Mouser Nr. 603-RC0603FR-13240RL
R6: 1.5k; R_0603_1608Metric; Mouser Nr. 603-RT0603FRE101K5L
R7, R8: 68; R_0603_1608Metric; Mouser Nr. 71-CRCW0603-68-E3
R17: 40.2k; R_0603_1608Metric; Mouser Nr. 754-RR0816P-4022D59C
R18: 4.7k; R_0603_1608Metric; Mouser Nr. 603-RT0603FRE074K7L
U1: STM32L412K8Tx; LQFP-32_7x7mm_P0.8mm; Mouser Nr. 511-STM32L412K8T6
U2: USBLC6-2SC6; SOT-23-6; Mouser Nr. 511-USBLC6-2SC6
U3: CURRENT_SENS; L01Z; Mouser Nr. 838-L01Z050S05
U4: RFM95W-868S2; HOPERF_RFM9XW_SMD; Mouser Nr. 223-RFM95W-868S2
U5: MCP1812AT-033/TT; SOT-23; Mouser Nr. 579-MCP1812AT-033/TT
U6: OPA990; SOT-23-5; Mouser Nr. 595-OPA990IDBVR

Connections:
+5V: D2.2 (A), J4.2, J5.2, R1k1.1, R14.1, U3.3 (VCC), U6.5 (V+); also elsewhere on the board
+24V: J8.1, R17.1, R25.2
/Main/D+: J1.3 (D+), U2.6 (I/O1)
/Main/D-: J1.2 (D-), U2.4 (I/O2)
CURRENT_SENSE_OUT: R28.2, R29.1, U1.8 (PA2)
GND: AE1.2 (Shield), C1.2, C2.2, C3.2, C4.1, C5.1, C8.1, D1.1 (K), J1.5 (GND), J1.6 (Shield), J2.2, J4.3, J5.3, J8.3, Q1.2 (E), Q3.2 (E), Q5.2 (E), Q6.2 (E), R3.1, R4.2, R10.1, R11.2, R13.1, R18.2, R20.1, R24.1, R27.2, R29.2, U1.16 (VSS), U1.32 (VSS), U2.2 (GND), U3.2 (GND), U4.1 (GND), U4.8 (GND), U4.10 (GND), U5.3 (GND), U6.2 (V-); also elsewhere on the board
HALL_TTL_A: U1.19 (PA9); also elsewhere on the board
HALL_TTL_B: U1.18 (PA8); also elsewhere on the board
LED_EXT: R23.1, U1.27 (PB4)
unnamed: AE1.1 (A), U4.9 (ANT)
unnamed: C3.1, D2.1 (K), D7.1 (K), U5.2 (IN)
unnamed: C4.2, R1.2, U1.4 (NRST)
unnamed: D1.2 (A), R5.2
unnamed: J3.1, R25.1
unnamed: J3.2, R26.1
unnamed: J3.3, Q6.3 (C)
unnamed: Q1.1 (B), R9.2, R10.2
unnamed: Q3.1 (B), R12.2, R13.2
unnamed: Q5.1 (B), R19.2, R20.2
unnamed: Q5.3 (C), R22.2
unnamed: Q6.1 (B), R23.2, R24.2
unnamed: R4.1, U1.31 (PH3)
unnamed: R5.1, U1.30 (PB7)
unnamed: R7.1, U1.21 (PA11)
unnamed: R8.1, U1.22 (PA12)
unnamed: R11.1, U3.1 (VOUT), U6.3 (+)
unnamed: R28.1, U6.1, U6.4 (-)
POWER_FET_OUT: J8.2, R22.1
POWER_SWITCH: R19.1, U1.6 (PA0)
PWM_1: R9.1, U1.25 (PA15)
PWM_2: R12.1, U1.26 (PB3)
PWM_OUT_1: J5.1, Q1.3 (C), R1k1.2
PWM_OUT_2: J4.1, Q3.3 (C), R14.2
RFM_DIO0: U1.2 (PC14), U4.14 (DIO0)
RFM_DIO1: U4.15 (DIO1)
RFM_DIO2: U1.14 (PB0), U4.16 (DIO2)
RFM_DIO3: U1.3 (PC15), U4.11 (DIO3)
RFM_DIO4: U4.12 (DIO4)
RFM_DIO5: U4.7 (DIO5)
RFM_NSS: U1.10 (PA4), U4.5 (NSS)
RFM_RST: U1.9 (PA3), U4.6 (RESET)
SPI_MISO: U1.12 (PA6), U4.2 (MISO)
SPI_MOSI: U1.13 (PA7), U4.3 (MOSI)
SPI_SCK: U1.11 (PA5), U4.4 (SCK)
SWCLK: J2.3, U1.24 (PA14)
SWDIO: J2.4, U1.23 (PA13)
SW_EXT: R26.2, R27.1, U1.28 (PB5)
USB_DM: R7.2, U2.3 (I/O2)
USB_DP: R6.1, R8.2, U2.1 (I/O1)
VBUS: D7.2 (A), J1.1 (VBUS), R2.1, U2.5 (VBUS)
VOLTAGE_MEASUREMENT: R17.2, R18.1, U1.7 (PA1)
VUSB: R2.2, R3.2, U1.15 (PB1)

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
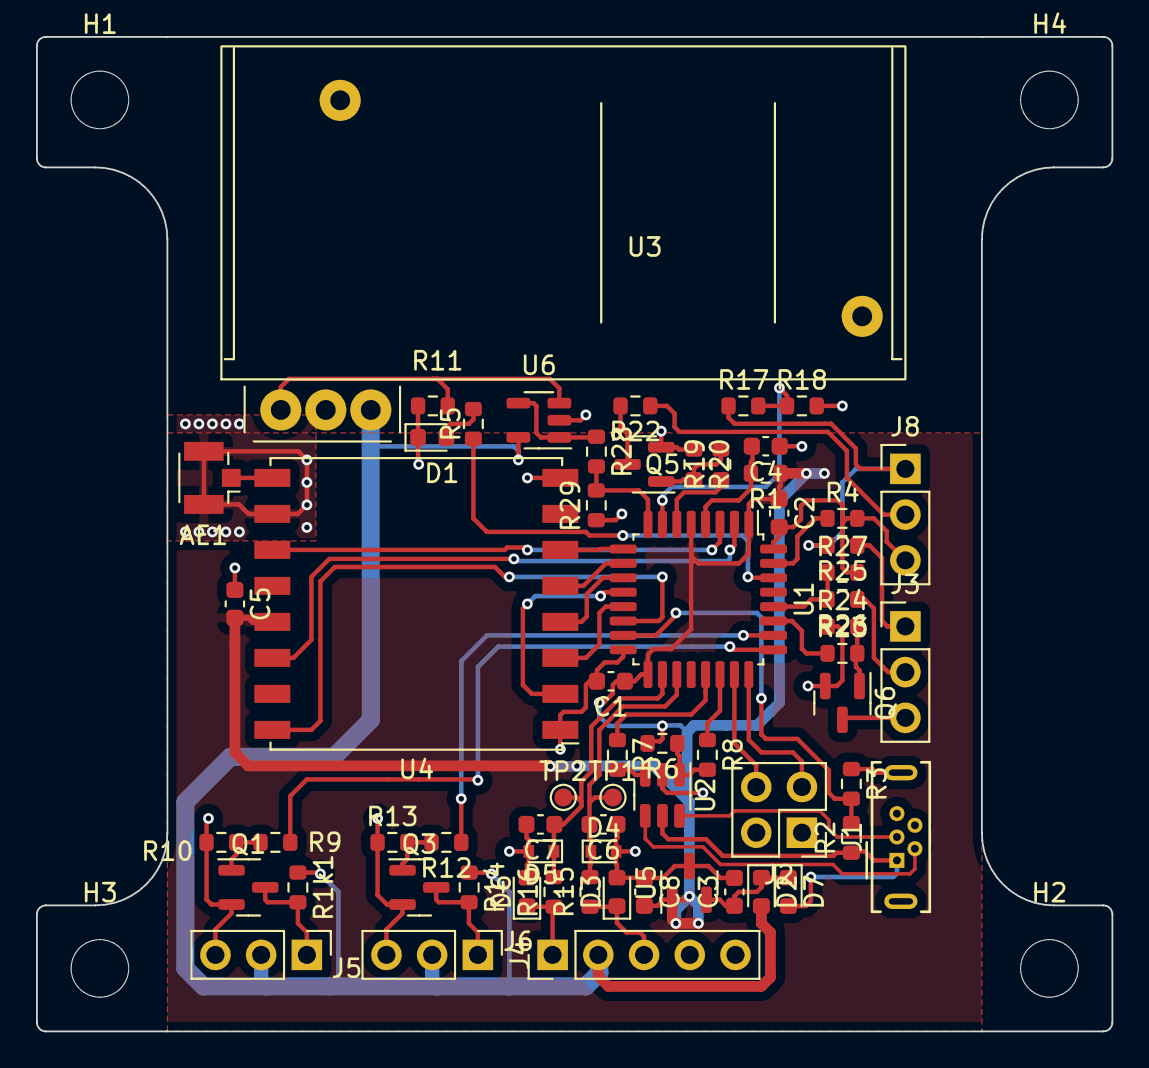
[picture p19: board Spanner.kicad_pcb from above]

Board: 2 copper layers, 59.8 x 55.2 mm, 68 parts (0 on the bottom side), 52 nets.
