MarcelKleiner/ViseClampingDevice/Firmware/Spanner/Spanner.ioc

Mcu.UserName=STM32L412K8Tx
PA0-CK_IN.GPIO_Label=POWER_SWITCH
PA0-CK_IN.Signal=GPIO_Output
PA1.GPIO_Label=VOLTAGE_MEASUREMENT
PA1.Signal=ADCx_IN6
PA11.Signal=USB_DM
PA12.Signal=USB_DP
PA2.GPIO_Label=CURRENT_MEASUREMENT
PA2.Signal=ADCx_IN7
PA3.GPIO_Label=RFM_RST
PA3.Signal=GPIO_Output
PA4.GPIO_Label=RFM_NSS
PA4.Signal=GPIO_Output
PA5.Signal=SPI1_SCK
PA6.Signal=SPI1_MISO
PA7.Signal=SPI1_MOSI
PA8.Signal=S_TIM1_CH1
PA9.Signal=S_TIM1_CH2
PB0.GPIO_Label=RFM_DI2
PB0.Signal=GPIO_Input
PB1.GPIO_Label=VUSB
PB1.Signal=GPIO_Input
PB5.GPIO_Label=SW_EXT
PB5.Signal=GPIO_Input
PB7.GPIO_Label=LED
PB7.Signal=GPIO_Output
