MarcelKleiner/ViseClampingDevice/Firmware/Spanner/Core/Src/main.cpp

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
/* Includes ------------------------------------------------------------------*/
#include "main.h"
#include "adc.h"
#include "dma.h"
#include "spi.h"
#include "tim.h"
#include "usb_device.h"
#include "gpio.h"

/* USER CODE BEGIN Includes */
#include "AppMain/AppMain.h"
/* USER CODE END Includes */


/* USER CODE BEGIN PV */
AppMain appMain;
/* USER CODE END PV */

void SystemClock_Config(void);
/**
  * @brief  The application entry point.
  * @retval int
  */
int main(void)
{
  /* MCU Configuration--------------------------------------------------------*/

  /* Reset of all peripherals, Initializes the Flash interface and the Systick. */
  HAL_Init();

  /* Configure the system clock */
  SystemClock_Config();

  /* Initialize all configured peripherals */
  MX_GPIO_Init();
  MX_ADC1_Init();
  MX_DMA_Init();
  MX_SPI1_Init();
  MX_TIM1_Init();
  MX_TIM2_Init();
  MX_USB_DEVICE_Init();
  MX_TIM6_Init();
  MX_TIM16_Init();


 // MX_USB_DEVICE_Init();
  /* USER CODE BEGIN 2 */

  appMain.Startup();


  /* USER CODE END 2 */

  /* Infinite loop */
  /* USER CODE BEGIN WHILE */
  while (1)
  {
    /* USER CODE END WHILE */

    /* USER CODE BEGIN 3 */
  }
  /* USER CODE END 3 */
}

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
/* USER CODE BEGIN 4 */


void HAL_TIM_PeriodElapsedCallback(TIM_HandleTypeDef *htim){

	if(htim->Instance == TIM16){
		appMain.taskHandler.UpdateTasks();
	}

}


void HAL_ADC_ConvCpltCallback(ADC_HandleTypeDef *hadc){
	if(hadc->Instance == ADC1){
		HAL_ADC_Stop_DMA(&hadc1);
		appMain.ADCRead(hadc);
	}
}

void USB_CDC_RX_Interrupt(uint8_t *data, uint32_t length)
{

}

/* USER CODE END 4 */
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
