MarcelKleiner/ViseClampingDevice/(commit log)

2022-10-18 HW design spanner and cobot
    [BOM.xlsx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]
2022-10-24 softwareproject added
    [Connection.kicad_sch, Encoder.kicad_sch, IO.kicad_sch, Main.kicad_sch, Supply.kicad_sch, Technik.xlsx, ViseClampingDevice.kicad_pcb, ViseClampingDevice.kicad_sch]
2022-11-13 Software implementation
    [BOM.xlsx, Cobot.kicad_pcb, Cobot.kicad_sch, Connection.kicad_sch, Main.kicad_sch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]
2022-12-10 Update Firmware
    [Cobot.kicad_pcb, Main.kicad_sch]
2022-12-26 Update various modules
    [Main.kicad_sch, Spanner.kicad_pcb, Spanner.kicad_sch]
2022-12-27 update spanner
    [Main.kicad_sch, Spanner.kicad_pcb]
2023-01-22 FW update
    [Main.kicad_sch, Spanner.kicad_pcb, Spanner.kicad_sch]
2023-07-03 Update HW and SW
    [Cobot.kicad_pcb, Cobot.kicad_sch, Connection.kicad_sch, IO_Analog.kicad_sch, IO_Digital.kicad_sch, Main.kicad_sch, Supply.kicad_sch]
2023-11-26 software stabilisation
    [Encoder.kicad_sch, Main.kicad_sch, Spanner.kicad_sch]
2023-12-19 updat Teach mode and configuration tool
    [PowerSwitch.kicad_pcb, PowerSwitch.kicad_sch]
